dallday/MK14ESP8266keys/pcb/mk14keyscp_pcb.png

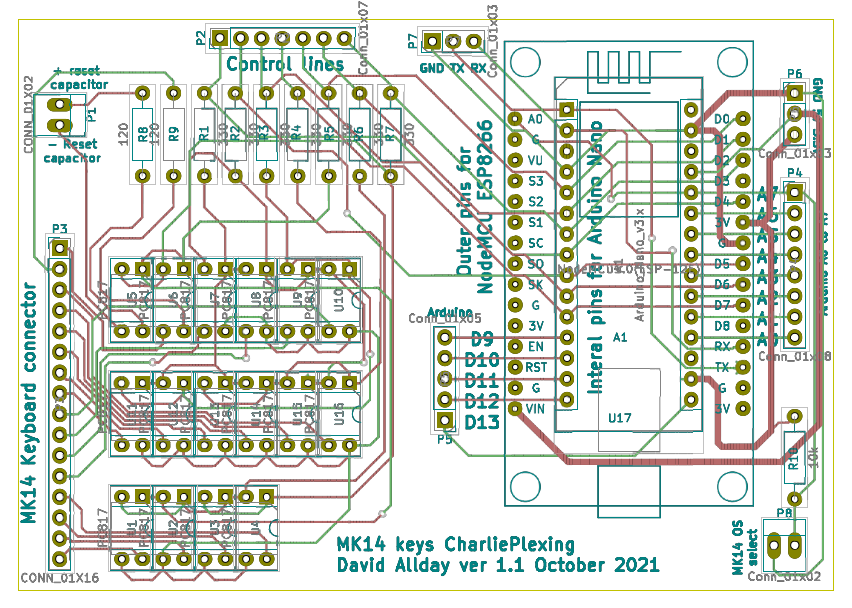
pcb/mk14keyscp_pcb.png
