dallday/MK14ESP8266keys/pcb/mk14schemaMod1.pdf

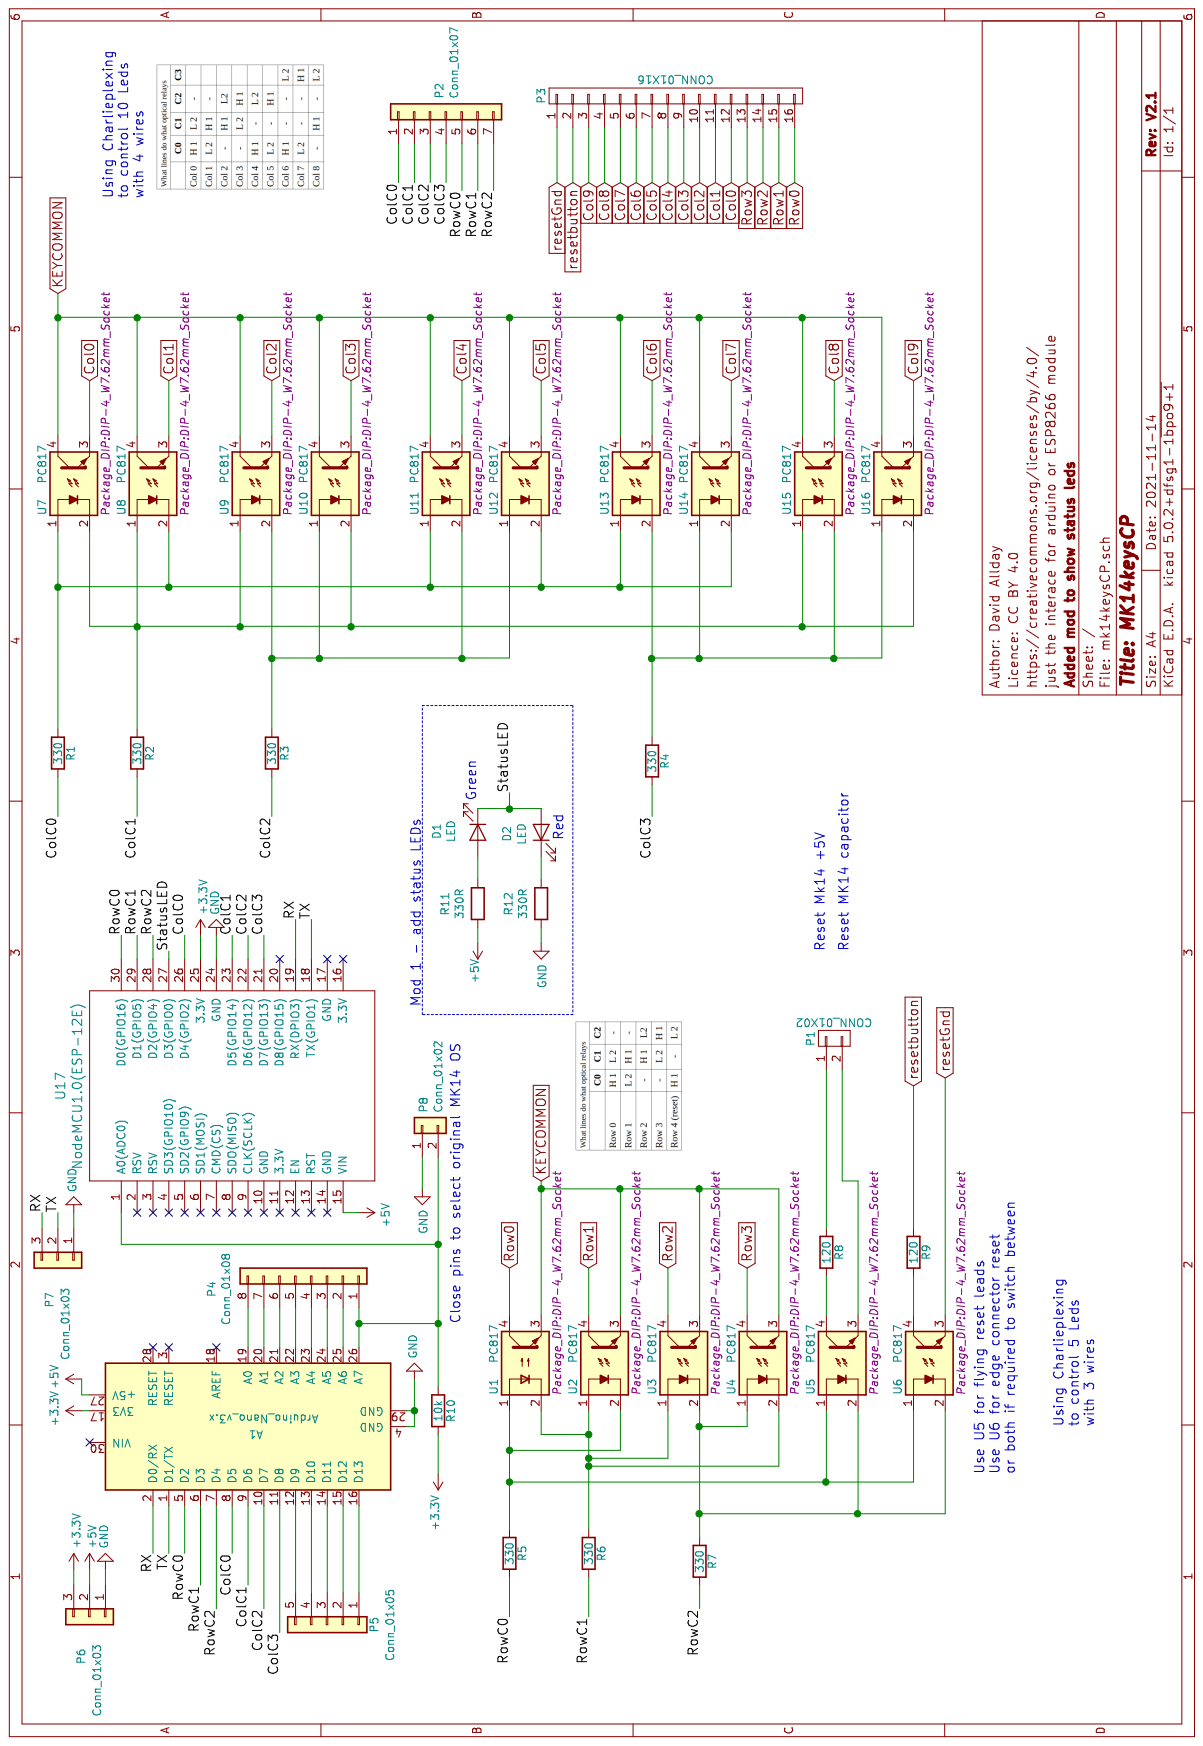
[picture p9: page 1]
