dallday/MK14ESP8266keys/pcb/mk14keyscp_schema.pdf

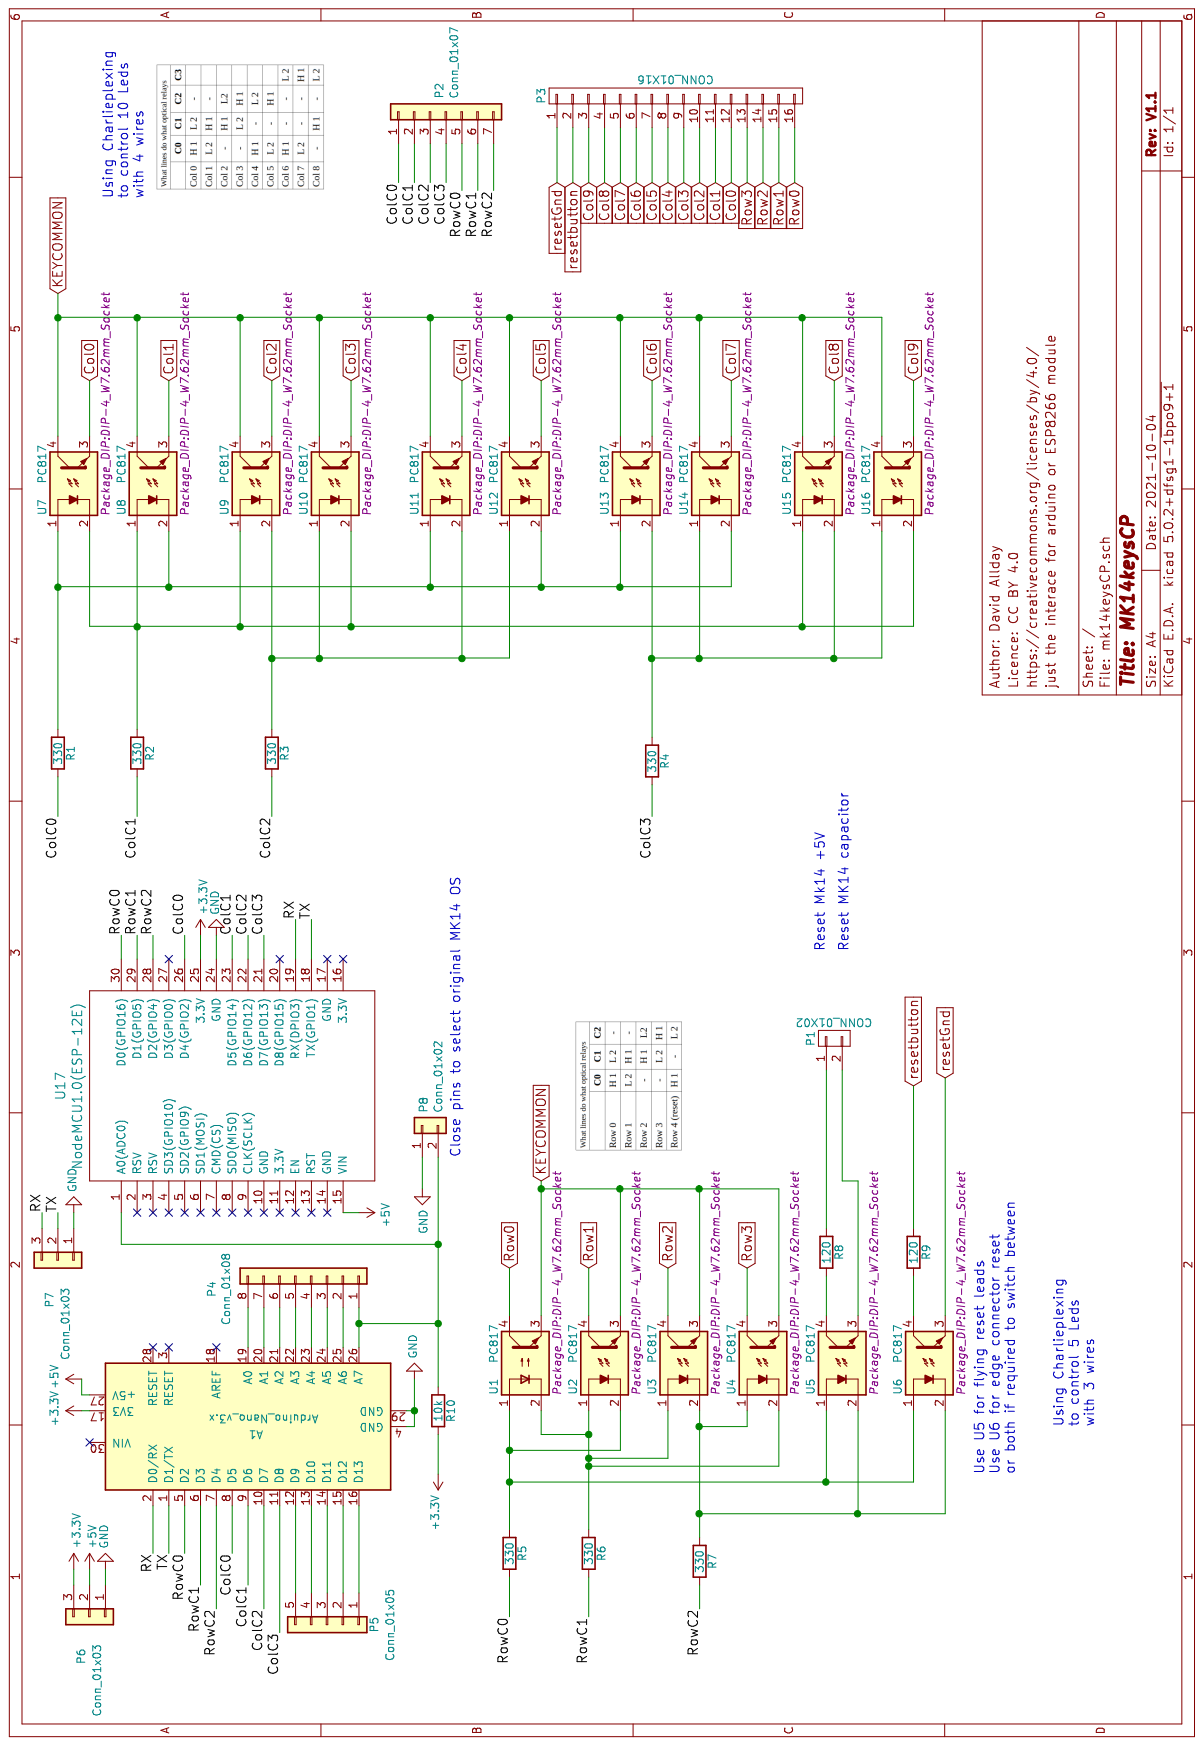
[picture p10: page 1]
