dallday/MK14ESP8266keys/(commit log)

2021-11-13 Add images of the PCB schema and board layout
2021-11-13 Kicad files
    These were generated in Kicad version 5.0.2
2021-11-13 Gerber files in zipped format
    These files are ready to send to companies like jlcpcb to make the board.
2021-11-13 basic MK14keys for the board
    A version of MK14keys using the ESP8266 or Arduino on mk14keyscp PCB.
2021-11-13 ESP8266 webserver for the board
    This sketch provides a webserver that allows for the storeage of .hex files and their use to "program" the MK14 via the "keys"
2021-11-14 Schema for Mod 1
    Shows the additional circuit to provide wifi status LEDs
2021-11-14 The arduino files for MK14ESP8266keys
    loaded up all the files for he MK14ESP8266keys folder
    gives the complete sketch.
2021-11-14 remove check on wifi setup
    Seems the test would always fail and it is not needed
    [wificode.ino]
2021-11-14 Some notes on the PCB
2021-11-20 Some notes on the PCB
    Updated to include keystrokes page
